tausen/OpenMower/Hardware/OpenMowerMainboard/OpenMowerMainboard.kicad_pcb

## KiCad design Hardware/OpenMowerMainboard/OpenMowerMainboard.kicad_pcb (2024-08-15)

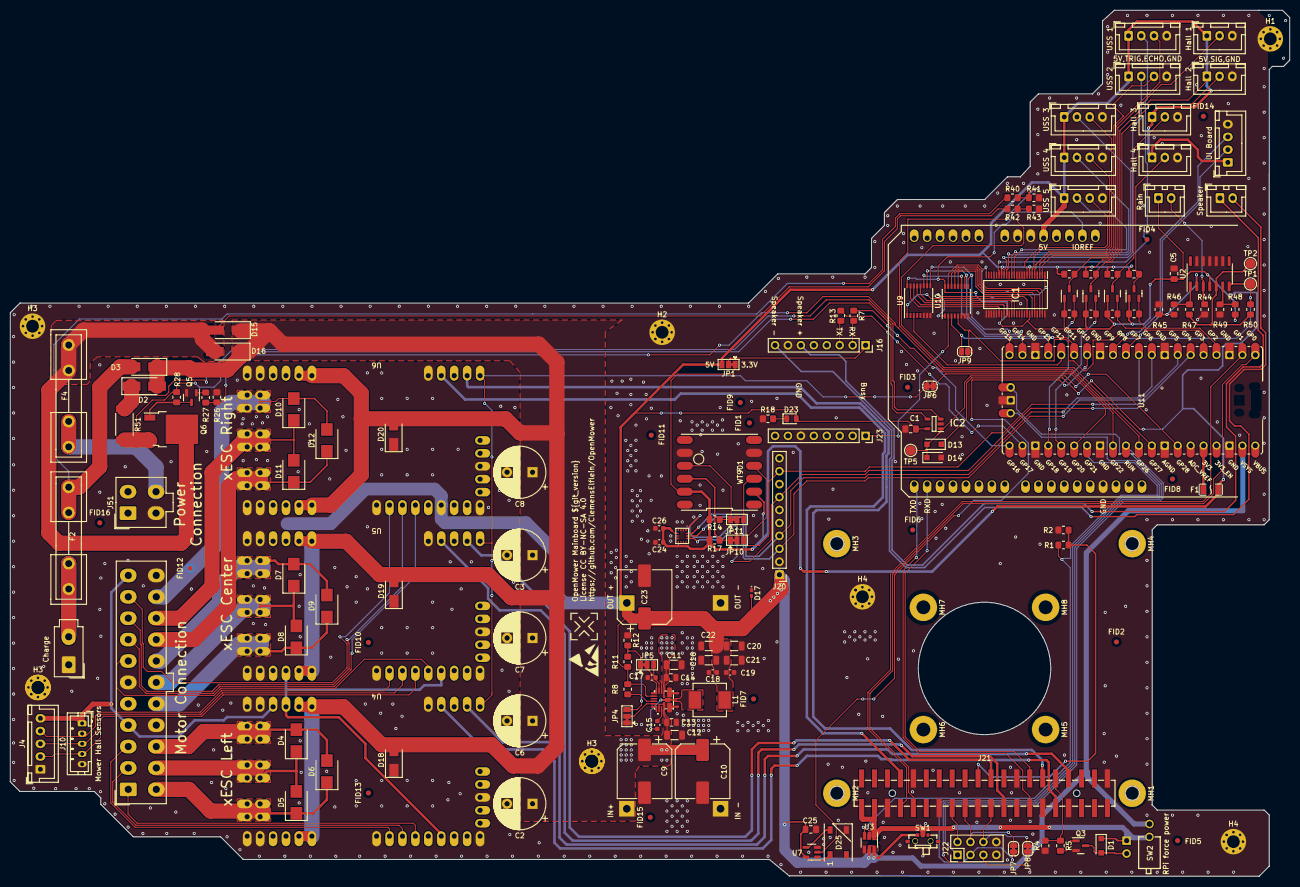
[picture p1: board OpenMowerMainboard.kicad_pcb from above]

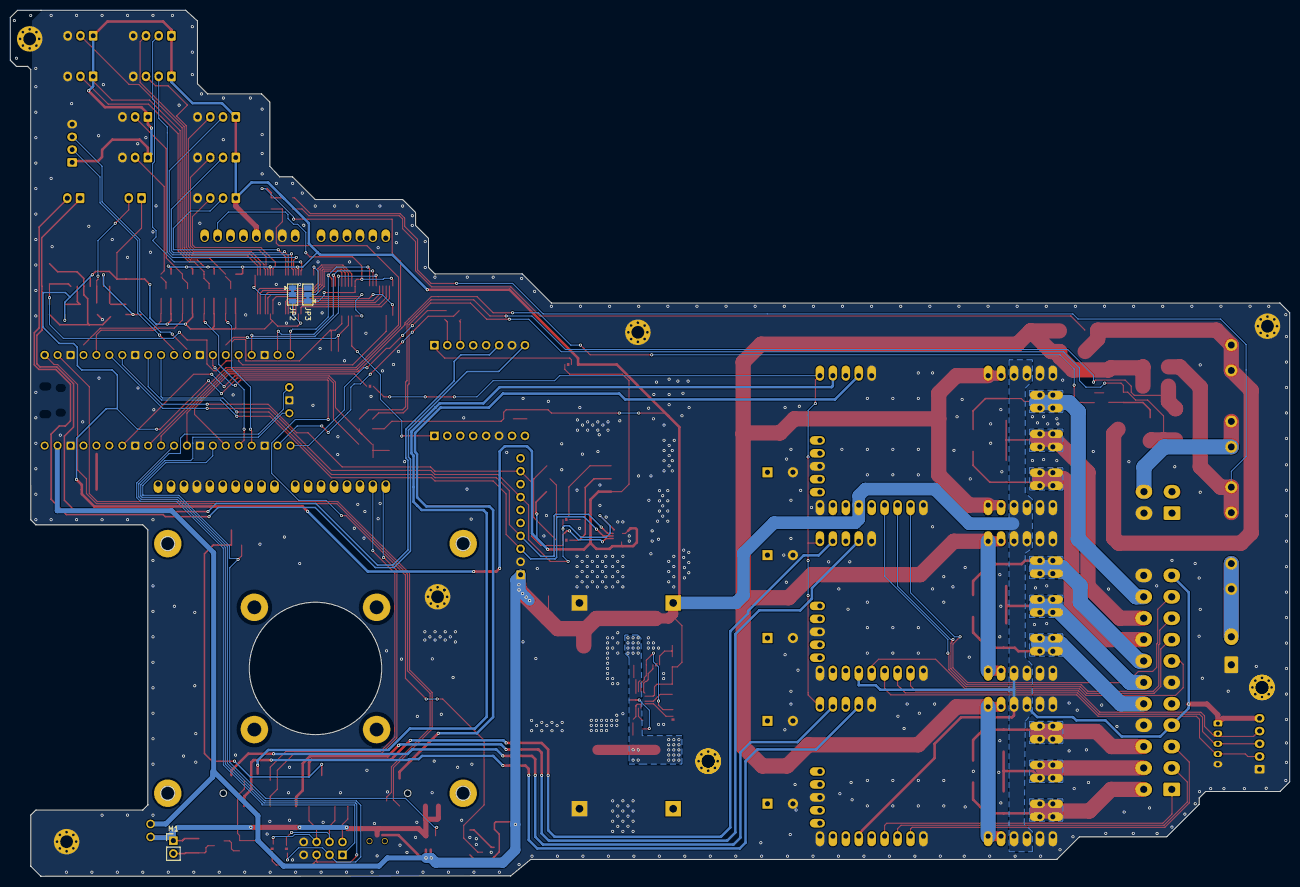
[picture p2: board OpenMowerMainboard.kicad_pcb from below]

Board: 2 copper layers, 251.2 x 170.0 mm, 182 parts (3 on the bottom side), 130 nets.

Parts:
AC1201: LSM6DSOTR; LGA-14_2.5X3X0.86_
C1, C5, C25: 100nF; C_0805_2012Metric_Pad1.18x1.45mm_HandSolder
C2, C3, C6, C7, C8: 220uF; CP_Radial_D10.0mm_P5.00mm
C9, C23: 680uF; CP_Elec_10x12.5
C10: DNP; CP_Elec_10x12.5
C11, C12: 4.7uF; C_1206_3216Metric
C13, C14: 1uF; C_0805_2012Metric
C15, C18, C19, C24, C26: 0.1uF; C_0603_1608Metric
C16, C20, C21, C22: 22uF; C_1206_3216Metric
C17: 2.2uF; C_0603_1608Metric
D1: D_Schottky; D_SOD-123F
D2, D3, D15, D16: D_Schottky; D_SMA_Handsoldering
D4, D5, D6, D7, D8, D9, D10, D11, D12: DNP; D_SMB
D13, D14: DNP; D_SOD-123F
D17: DNP; D_0402_1005Metric_Pad0.77x0.64mm_HandSolder
D18, D19, D20: DNP; D_SMA
D23: LED; LED_0805_2012Metric
D25: WS2812B; LED_WS2812B_PLCC4_5.0x5.0mm_P3.2mm
F1: nSMD035-16V; F1206
F2, F4: Fuse; Fuseholder5x20_horiz_open_inline_Type-I
FID1, FID2, FID3, FID4, FID5, FID6, FID7, FID8, FID9, FID10, FID11, FID12, FID13, FID14, FID15, FID16: Fiducial; Fiducial_1mm_Mask2mm
H1, H2, H3, H3#2, H3#3, H4, H4#2: MountingHole_Pad; MountingHole_2.5mm_Pad_Via
IC1: 74ALVC164245DGG,11; SOP50P810X120-48N
IC2: TSC101CILT; SOT95P280X145-5N
IC3: MAX20405AFOF_VY+T; MAX2040
J1: Conn_02x11_Top_Bottom; Molex_Mini-Fit_Jr_5566-22A_2x11_P4.20mm_Vertical
J3: Conn_01x02; Molex_Mini-Fit_Jr_5566-02A_2x01_P4.20mm_Vertical
J4: Conn_01x05; JST_XH_B5B-XH-A_1x05_P2.50mm_Vertical
J5, J6, J7, J8, J9, J19: Conn_01x04; JST_XH_B4B-XH-A_1x04_P2.50mm_Vertical
J10: Conn_01x05; JST_PH_B5B-PH-K_1x05_P2.00mm_Vertical
J11, J12, J13, J14: Conn_01x03_Male; JST_XH_B3B-XH-A_1x03_P2.50mm_Vertical
J16, J23: Conn_01x08; PinSocket_1x08_P2.54mm_Vertical
J17, J18: Conn_01x02; JST_XH_B2B-XH-A_1x02_P2.50mm_Vertical
J20: Conn_01x10_Female; PinHeader_1x10_P2.54mm_Vertical
J21: Raspberry_Pi_2_3; HDR-SMD_40P-P2.54-V-F-R2-C20-S8.8-EH
J22: Conn_02x04_Odd_Even; PinHeader_2x04_P2.54mm_Vertical
J51: Conn_01x04; Molex_Mini-Fit_Jr_5566-04A_2x02_P4.20mm_Vertical
JP1, JP2, JP3, JP4, JP5: SolderJumper_3_Bridged12; SolderJumper-3_P1.3mm_Bridged12_Pad1.0x1.5mm
JP6, JP7, JP8: SolderJumper_2_Bridged; SolderJumper-2_P1.3mm_Bridged_RoundedPad1.0x1.5mm
JP9: SolderJumper_2_Open; SolderJumper-2_P1.3mm_Open_RoundedPad1.0x1.5mm
JP10, JP11: I2C_OR_TTL; SolderJumper-3_P1.3mm_Bridged12_Pad1.0x1.5mm
L1: 4.7uH 5A; L_Vishay_IHLP-2525
LOGO1: LOGO; ESD-Logo_6.6x6mm_SilkScreen
LOGO2: ESD-Logo_6.6x6mm_SilkScreen
M1: Fan; PinHeader_1x02_P2.54mm_Vertical
MH1, MH2, MH3, MH4, MH5, MH6, MH7, MH8: MountingHole_2.7mm_M2.5_Pad
Q3, Q5, Q13, Q14, Q15, Q16: BSS138; SOT-23
Q6: Q_PMOS_GDS; TO-252-2
R1, R2, R4, R12, R26, R28, R40, R42, R48, R50: 10k; R_0805_2012Metric_Pad1.20x1.40mm_HandSolder
R3, R6, R7, R9, R10, R13, R15, R16, R18, R19, R20, R41, R43, R45, R47: 1k; R_0805_2012Metric_Pad1.20x1.40mm_HandSolder
R5, R27: 150; R_0805_2012Metric_Pad1.20x1.40mm_HandSolder
R8: DNP; R_0805_2012Metric_Pad1.20x1.40mm_HandSolder
R11: 53k6 1%; R_0805_2012Metric_Pad1.20x1.40mm_HandSolder
R14, R17, R49: 4k7; R_0805_2012Metric_Pad1.20x1.40mm_HandSolder
R44, R46: 47k; R_0805_2012Metric_Pad1.20x1.40mm_HandSolder
R51: 0.003R; R_2512_6332Metric_Pad1.40x3.35mm_HandSolder
RP?: Raspberry_Pi_2_3; raspberrypi_2_3
SW1: MK-11C04-G013; SW-SMD_MK-11C04-G013
SW2: DA-01BP; SW-TH_DA-01BP
TP1, TP2, TP5: TestPoint; TestPoint_Pad_D2.0mm
U1: DNP; LM2596S_MODULE
U2: MCP604; SOIC-14_3.9x8.7mm_P1.27mm
U3: SIP32509DT; SOT-23-6_Handsoldering
U4, U5, U6: xESC2
U7: SN74LV1T34DBV; SOT-23-5
U9, U10: 74HC4051; SSOP-16_4.4x5.2mm_P0.65mm
U11: Pico; Raspberry_Pi_Pico_SMT_THT
WT901: Conn_02x06_Female; WT901
XA1: Arduino_Uno_Shield

Connections:
+3V3: AC1201.5 (VDDIO), AC1201.8 (VDD), C5.2, C24.1, C26.1, D13.1 (K), F1.2, IC1.31 (VCC(A)_1), IC1.42 (VCC(A)_2), J17.1, JP1.1 (A), JP2.3 (B), JP3.1 (A), Q13.1 (G), Q14.1 (G), Q15.1 (G), Q16.1 (G), R3.1, R9.1, R14.2, R15.1, R17.2, R19.1, R48.2, U2.4 (V+), U9.16 (VCC), U10.16 (VCC), WT901.a2 (VCC), WT901.b2 (VCC), XA1.IORF (IOREF)
+5V: C1.1, C16.1, C18.1, C19.1, C20.1, C21.1, C22.1, C23.1, C25.1, D17.2 (A2), D23.2 (A), D25.1 (VDD), IC1.7 (VCC(B)_1), IC1.18 (VCC(B)_2), IC2.5 (VCC), IC3.13 (OUT), J1.4, J1.11, J4.5, J5.1, J6.1, J7.1, J8.1, J9.1, J10.1, J11.1, J12.1, J13.1, J14.1, J19.1, J20.1, JP1.3 (B), L1.2, R6.1, R8.2, R10.1, R11.2, R16.1, R20.1, SW1.1, SW2.2, U1.3 (OUT+), U3.5 (VIN), U3.6 (VIN), U4.5V, U5.5V, U6.5V, U7.5 (VCC), U11.39 (VSYS), XA1.5V1 (5V)
/CHARGE_CURRENT: D13.2 (A), D14.1 (K), IC2.1 (OUT), TP5.1, U11.34 (GPIO28_ADC2)
/ESCs/ESC_SHUTDOWN: JP6.1 (A), U11.26 (GPIO20)
/ESCs/MC_HALL_U: J4.2, J10.4, U5.4 (HALL_U)
/ESCs/MC_HALL_V: J4.3, J10.3, U5.5 (HALL_V)
/ESCs/MC_HALL_W: J4.4, J10.2, U5.6 (HALL_W)
/ESCs/MC_PHASE_U: D7.2 (A2), D9.2 (A2), J1.18, U5.U
/ESCs/MC_PHASE_V: D7.1 (A1), D8.2 (A2), J1.17, U5.V
/ESCs/MC_PHASE_W: D8.1 (A1), D9.1 (A1), J1.16, U5.W
/ESCs/MC_RX: J21.24 (~CE0/GPIO8), U5.14 (NCS/RX)
/ESCs/MC_TEMP: J1.7, U5.3 (TEMPERATURE)
/ESCs/MC_TX: J21.21 (MISO0/GPIO9), U5.12 (MOSI/TX)
/ESCs/ML_HALL_U: J1.1, U4.4 (HALL_U)
/ESCs/ML_HALL_V: J1.2, U4.5 (HALL_V)
/ESCs/ML_HALL_W: J1.3, U4.6 (HALL_W)
/ESCs/ML_PHASE_U: D4.2 (A2), D6.2 (A2), J1.14, U4.U
/ESCs/ML_PHASE_V: D4.1 (A1), D5.2 (A2), J1.13, U4.V
/ESCs/ML_PHASE_W: D5.1 (A1), D6.1 (A1), J1.12, U4.W
/ESCs/ML_RX: J21.32 (PWM0/GPIO12), U4.14 (NCS/RX)
/ESCs/ML_TX: J21.33 (PWM1/GPIO13), U4.12 (MOSI/TX)
/ESCs/MR_HALL_U: J1.8, U6.4 (HALL_U)
/ESCs/MR_HALL_V: J1.9, U6.5 (HALL_V)
/ESCs/MR_HALL_W: J1.10, U6.6 (HALL_W)
/ESCs/MR_PHASE_U: D10.2 (A2), D12.2 (A2), J1.21, U6.U
/ESCs/MR_PHASE_V: D10.1 (A1), D11.2 (A2), J1.20, U6.V
/ESCs/MR_PHASE_W: D11.1 (A1), D12.1 (A1), J1.19, U6.W
/ESCs/MR_RX: J21.7 (GCLK0/GPIO4), U6.14 (NCS/RX)
/ESCs/MR_TX: J21.29 (GCLK1/GPIO5), U6.12 (MOSI/TX)
/GPS/RXD: J21.27 (ID_SD/GPIO0), XA1.D1 (D1_TX0)
/GPS/TXD: J21.28 (ID_SC/GPIO1), XA1.D0 (D0_RX0)
/IMU/MISO: AC1201.1 (SDO/SA0), J20.7, JP11.2 (C), U11.6 (GPIO4)
/IMU/MOSI: AC1201.14 (SDA), J20.4, U11.10 (GPIO7)
/IMU/SCK: AC1201.13 (SCL), J20.3, U11.9 (GPIO6)
/IMU/~CS: AC1201.12 (CS), J20.9, JP10.2 (C), U11.7 (GPIO5)
/RAIN_DETECTED: JP9.1 (A), R50.2, TP1.1, U2.7, U10.5 (A5)
/RaspberryPi/PICO_RESET: J22.1, U11.30 (RUN)
/RaspberryPi/PICO_SWCLK: J22.5, JP8.1 (A), U11.41 (SWCLK)
/RaspberryPi/PICO_SWDIO: J22.3, JP7.1 (A), U11.43 (SWDIO)
/RaspberryPi/POWER_EN: R1.1, U3.3 (ENABLE), U11.27 (GPIO21)
/RaspberryPi/RASPI_FAN_ON: J21.31 (GCLK2/GPIO6), R4.2, R5.1
/RaspberryPi/RASPI_POWER: D1.1 (K), J21.2 (5V), J21.4 (5V), M1.1 (+), SW1.C, SW2.1, U3.1 (VOUT), U3.2 (VOUT)
/RaspberryPi/UART0_RXD: J21.10 (GPIO15/RXD), U11.1 (GPIO0)
/RaspberryPi/UART0_TXD: J21.8 (GPIO14/TXD), U11.2 (GPIO1)
/RobotConnectors/CHARGE_SHUNT_MINUS: IC2.4 (VM), Q6.3 (S), R28.1, R51.2
/RobotConnectors/CHARGE_SHUNT_PLUS: D2.1 (K), IC2.3 (VP), R51.1
/RobotConnectors/ENABLE_CHARGE: R26.1, R27.1, U11.29 (GPIO22)
/RobotConnectors/HALL_SWITCH_1: Q13.2 (S), R3.2, U11.24 (GPIO18)
/RobotConnectors/HALL_SWITCH_1_5V: J11.2, Q13.3 (D), R6.2
/RobotConnectors/HALL_SWITCH_2: Q14.2 (S), R9.2, U11.25 (GPIO19)
/RobotConnectors/HALL_SWITCH_2_5V: J12.2, Q14.3 (D), R10.2
/RobotConnectors/HALL_SWITCH_3: Q15.2 (S), R15.2, U11.5 (GPIO3)
/RobotConnectors/HALL_SWITCH_3_5V: J13.2, Q15.3 (D), R16.2
/RobotConnectors/HALL_SWITCH_4: Q16.2 (S), R19.2, U11.4 (GPIO2)
/RobotConnectors/HALL_SWITCH_4_5V: J14.2, Q16.3 (D), R20.2
/RobotConnectors/LED_RX: J19.2, U11.11 (GPIO8)
/RobotConnectors/LED_TX: J19.3, U11.12 (GPIO9)
/RobotConnectors/RAIN-: J17.2, R44.2, U2.3 (+)
/RobotConnectors/SPEAKER_MINUS: J16.8, J18.2
/RobotConnectors/SPEAKER_PLUS: J16.6, J18.1
/RobotConnectors/USS_1_ECHO: IC1.47 (1A0), U10.15 (A2)
/RobotConnectors/USS_1_ECHO_5V: IC1.2 (1B0), J5.3
/RobotConnectors/USS_1_TRIGGER: IC1.30 (2A4), U9.15 (A2)
/RobotConnectors/USS_1_TRIGGER_5V: IC1.19 (2B4), J5.2
/RobotConnectors/USS_2_ECHO: IC1.46 (1A1), U10.14 (A1)
/RobotConnectors/USS_2_ECHO_5V: IC1.3 (1B1), J6.3
/RobotConnectors/USS_2_TRIGGER: IC1.32 (2A3), U9.14 (A1)
/RobotConnectors/USS_2_TRIGGER_5V: IC1.17 (2B3), J6.2
/RobotConnectors/USS_3_ECHO: IC1.44 (1A2), U10.13 (A0)
/RobotConnectors/USS_3_ECHO_5V: IC1.5 (1B2), J7.3
/RobotConnectors/USS_3_TRIGGER: IC1.33 (2A2), U9.13 (A0)
/RobotConnectors/USS_3_TRIGGER_5V: IC1.16 (2B2), J7.2
/RobotConnectors/USS_4_ECHO: IC1.43 (1A3), U10.12 (A3)
/RobotConnectors/USS_4_ECHO_5V: IC1.6 (1B3), J8.3
/RobotConnectors/USS_4_TRIGGER: IC1.35 (2A1), U9.12 (A3)
/RobotConnectors/USS_4_TRIGGER_5V: IC1.14 (2B1), J8.2
/RobotConnectors/USS_5_ECHO: IC1.41 (1A4), U10.1 (A4)
/RobotConnectors/USS_5_ECHO_5V: IC1.8 (1B4), J9.3
/RobotConnectors/USS_5_TRIGGER: IC1.36 (2A0), U9.1 (A4)
/RobotConnectors/USS_5_TRIGGER_5V: IC1.13 (2B0), J9.2
/RobotConnectors/V_BATTERY: D15.2 (A), D16.2 (A), F4.2, Q6.2 (D), R42.2
/RobotConnectors/V_CHARGE: D3.2 (A), F2.1, R40.2
/pico/MUX_ADDRESS_0: U9.11 (S0), U10.11 (S0), U11.17 (GPIO13)
/pico/MUX_ADDRESS_1: U9.10 (S1), U10.10 (S1), U11.19 (GPIO14)
/pico/MUX_ADDRESS_2: U9.9 (S2), U10.9 (S2), U11.20 (GPIO15)
/pico/MUX_INPUT: JP9.2 (B), U10.3 (A), U11.15 (GPIO11)
/pico/MUX_OUTPUT: U9.3 (A), U11.16 (GPIO12)
/pico/SOUND_BUSY: J23.1, U10.2 (A6)
/pico/SOUND_RX: R13.1, U11.22 (GPIO17)
/pico/SOUND_TX: R7.2, U11.21 (GPIO16)
/pico/V_CHARGE: R40.1, R41.2, U11.31 (GPIO26_ADC0)
/pico/V_IN: R42.1, R43.2, U11.32 (GPIO27_ADC1)
GND: AC1201.2 (SDX), AC1201.3 (SCX), AC1201.6 (GND_1), AC1201.7 (GND_2), C1.2, C2.2, C3.2, C5.1, C6.2, C7.2, C8.2, C9.2, C10.2, C11.2, C12.2, C13.2, C14.2, C16.2, C17.2, C18.2, C19.2, C20.2, C21.2, C22.2, C23.2, C24.2, C25.2, C26.2, D14.2 (A), D17.1 (A1), D18.1 (A1), D19.1 (A1), D20.1 (A1), D25.3 (VSS), H1.1, H2.1, H3.1, H3#2.1, H3#3.1, H4.1, H4#2.1, IC1.4 (GND_1), IC1.9 (1B5), IC1.10 (GND_2), IC1.11 (1B6), IC1.12 (1B7), IC1.15 (GND_3), IC1.21 (GND_4), IC1.25 (~2OE), IC1.26 (2A7), IC1.27 (2A6), IC1.28 (GND_5), IC1.29 (2A5), IC1.34 (GND_6), IC1.39 (GND_7), IC1.45 (GND_8), IC1.48 (~1OE), IC2.2 (GND), IC3.4 (PGND_1), IC3.5 (PGND_2), IC3.7 (PGND_3), IC3.8 (PGND_4), IC3.10 (GND), J1.6, J1.15, J1.22, J3.1, J4.1, J5.4, J6.4, J7.4, J8.4, J9.4, J10.5, J11.3, J12.3, J13.3, J14.3, J16.7, J19.4, J20.2, J21.6 (GND), J21.9 (GND), J21.14 (GND), J21.20 (GND), J21.25 (GND), J21.30 (GND), J21.34 (GND), J21.39 (GND), J22.7, J22.8, J23.6, J51.3, JP2.1 (A), JP3.3 (B), JP4.1 (A), Q3.2 (S), Q5.2 (S), R2.1, R4.1, R12.1, R18.1, R26.2, R41.1, R43.1, R44.1, R45.1, R49.2, U1.1 (IN-), U1.4 (OUT-), U2.9 (-), U2.10 (+), U2.11 (V-), U2.12 (+), U2.13 (-), U3.4 (GND), U4.GND, U5.GND, U6.GND, U7.3 (GND), U9.6 (~E), U9.7 (VEE), U9.8 (GND), U10.6 (~E), U10.7 (VEE), U10.8 (GND), U11.3 (GND), U11.8 (GND), U11.13 (GND), U11.18 (GND), U11.23 (GND), U11.28 (GND), U11.33 (AGND), U11.38 (GND), U11.42 (SWGND), WT901.a5 (GND), WT901.b5 (GND), XA1.GND1 (GND), XA1.GND2 (GND), XA1.GND3 (GND)
unnamed: D1.2 (A), M1.2 (-), Q3.3 (D)
unnamed: D23.1 (K), R18.2
unnamed: D25.4 (DIN), U7.4 (Y)
unnamed: IC1.1 (1DIR), JP2.2 (C)
unnamed: IC1.24 (2DIR), JP3.2 (C)
unnamed: C17.1, IC3.11 (BIAS), JP4.3 (B), JP5.3 (B)
unnamed: C15.1, IC3.2 (BST)
unnamed: IC3.12 (FB_1), IC3.20 (FB_2), JP5.2 (C)
unnamed: C15.2, IC3.6 (LX_1), IC3.19 (LX_2), L1.1
unnamed: IC3.15 (PGOOD), R8.1
unnamed: IC3.16 (SYNC), JP4.2 (C)
unnamed: IC3.17 (SYNCOUT_1), IC3.18 (SYNCOUT_2)
unnamed: F2.2, J3.2
unnamed: J16.1, JP1.2 (C)
unnamed: J16.2, R7.1
unnamed: J16.3, R13.2
unnamed: J21.16 (GPIO23), J22.2
unnamed: J21.18 (GPIO24), J22.4, JP7.2 (B)
unnamed: J21.22 (GPIO25), J22.6, JP8.2 (B)
unnamed: J21.19 (MOSI0/GPIO10), R1.2, R2.2
unnamed: F4.1, J51.4
unnamed: JP5.1 (A), R11.1, R12.2
unnamed: JP6.2 (B), U4.11 (MISO), U5.11 (MISO), U6.11 (MISO)
unnamed: JP10.1 (A), R17.1, WT901.b3 (SCL)
unnamed: JP10.3 (B), WT901.a4 (TX)
unnamed: JP11.1 (A), R14.1, WT901.b4 (SDA)
unnamed: JP11.3 (B), WT901.a3 (RX)
unnamed: Q3.1 (G), R5.2
unnamed: Q5.3 (D), Q6.1 (G), R28.2
unnamed: Q5.1 (G), R27.2
unnamed: R46.1, R47.1, U2.1
unnamed: R45.2, R46.2, U2.2 (-)
unnamed: R47.2, R50.1, TP2.1, U2.5 (+)
unnamed: R48.1, R49.1, U2.6 (-)
unnamed: F1.1, U11.36 (3V3)
unnamed: U7.2 (A), U11.14 (GPIO10)
V_BATT: C2.1, C3.1, C6.1, C7.1, C8.1, C9.1, C10.1, C11.1, C12.1, C13.1, C14.1, D2.2 (A), D3.1 (K), D15.1 (K), D16.1 (K), D18.2 (A2), D19.2 (A2), D20.2 (A2), IC3.1 (EN), IC3.3 (SUP_1), IC3.9 (SUP_2), U1.2 (IN+), U4.VM (VIN), U5.VM (VIN), U6.VM (VIN)
