tausen/OpenMower/(commit log)

2024-06-01 Initial mainboard for Worx Landroid WR105SI
    Moved components and a few connectors around to make the mainboard fit
    in the Worx Landroid WR105SI. No functional changes (hopefully).
    Mounting holes are TBD.
    [OpenMowerMainboard.kicad_pcb]
2024-06-01 mainboard: squeeze bottom mid slightly
    Slightly reduce board height near bottom mid. Should give a bit more
    freedom when placing the board in the Landroid.
    [OpenMowerMainboard.kicad_pcb]
2024-06-08 mainboard: no mounting holes, squeeze connectors
    Remove mounting holes and squeeze upper right connectors
    [OpenMowerMainboard.kicad_pcb]
2024-06-09 mainboard: remove unused area in middle of board
    [OpenMowerMainboard.kicad_pcb]
2024-06-13 mainboard: fix J16-J23 distance
    Make distance between J16 and J23 fit the DFplayer again
    [OpenMowerMainboard.kicad_pcb]
2024-06-23 mainboard: landroid battery connector
    [OpenMowerMainboard.kicad_pcb, RobotConnectors.kicad_sch]
2024-07-23 KiCAD 8 in CI
2024-08-15 added user 6 layer to pcb
    [OpenMowerMainboard.kicad_pcb]
2024-08-15 mainboard: turbocase compatibility
    - Mounting holes for mounting PCB in case
    - Raspberry Pi 4 footprint for turbocase connector cutouts
    - Raspberry Pi 4 mounting hole footprint changed
    [OpenMowerMainboard.kicad_pcb]
