tausen/OpenMower/(notices)

Notices in the files:
Hardware/OpenMowerMainboard/OpenMowerMainboard.kicad_pcb:
License CC BY-NC-SA 4.0
